MRZ-N/MRZN-RadioAmateur-Resources/hardware/placa_un_modulo/RF4463PRO.kicad_pcb

## KiCad design hardware/placa_un_modulo/RF4463PRO.kicad_pcb (2026-10-23)

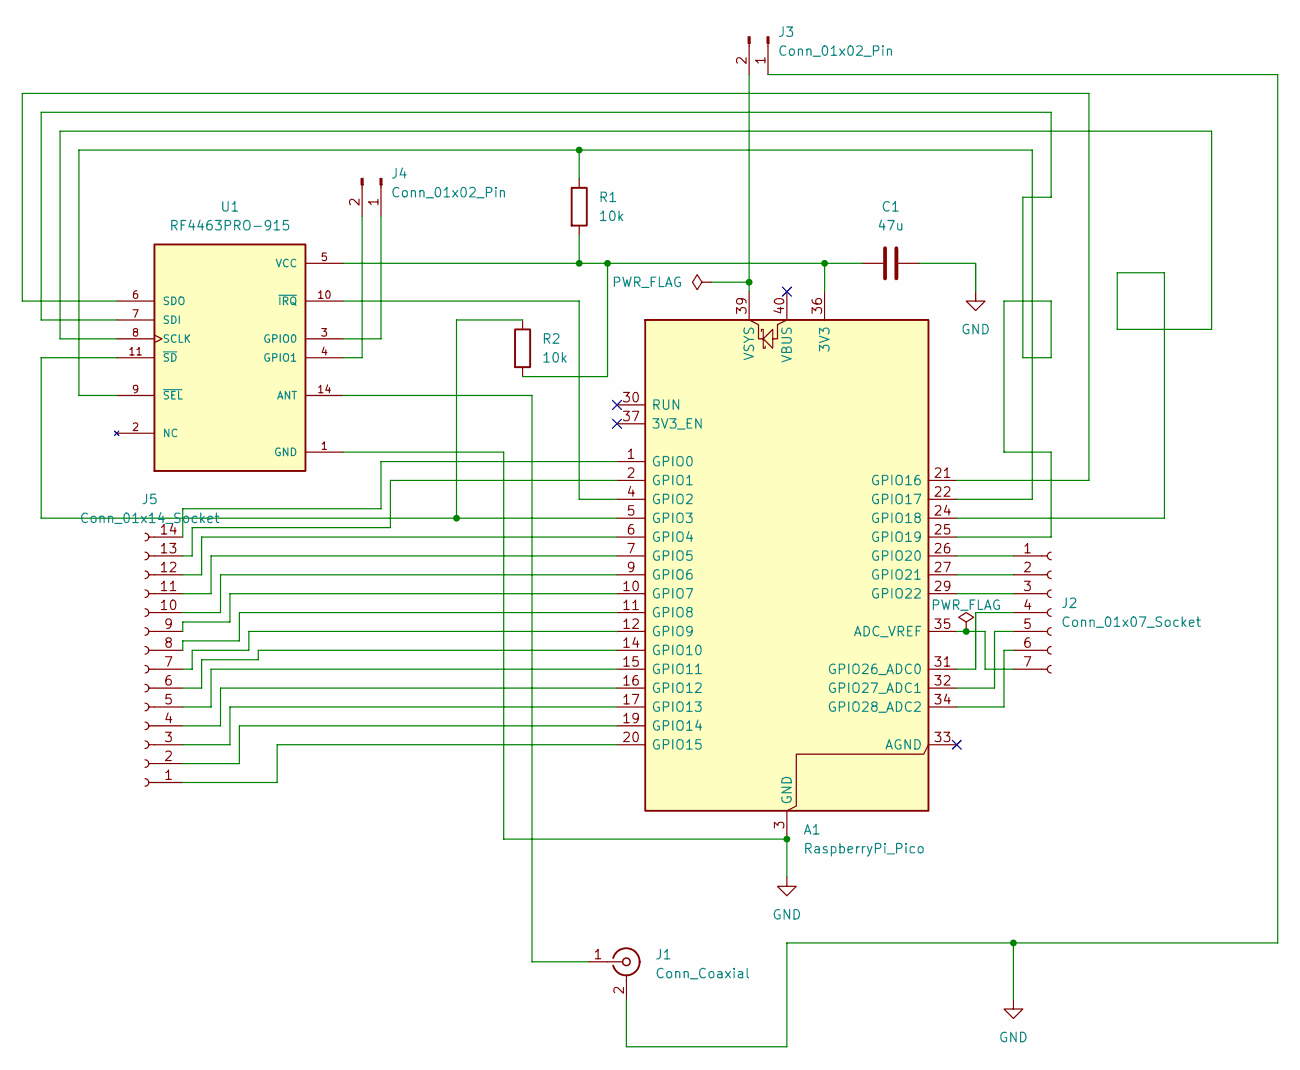
[picture p3: schematic RF4463PRO.kicad_sch]

Parts:
A1: RaspberryPi_Pico; RaspberryPi_Pico_SMD
C1: 47u; CP_Radial_D4.0mm_P2.00mm
J1: Conn_Coaxial; SMA_Amphenol_132289_EdgeMount
J2: Conn_01x07_Socket; PinSocket_1x07_P2.54mm_Vertical
J3: Conn_01x02_Pin; PinHeader_1x02_P2.54mm_Vertical
J4: Conn_01x02_Pin; PinSocket_1x02_P2.54mm_Vertical
J5: Conn_01x14_Socket; PinSocket_1x14_P2.54mm_Vertical
R1, R2: 10k; R_0805_2012Metric_Pad1.20x1.40mm_HandSolder
U1: RF4463PRO-915; XCVR_RF4463PRO-915; PARTREV V3.3

Connections:
GND: A1.3 (GND), A1.8 (GND), A1.13 (GND), A1.18 (GND), A1.23 (GND), A1.28 (GND), A1.38 (GND), C1.2, J1.2 (Ext), J3.1, U1.1 (GND), U1.12 (GND), U1.13 (GND)
unnamed: A1.36 (3V3), C1.1, R1.2, R2.2, U1.5 (VCC)
unnamed: A1.35 (ADC_VREF), J2.7
unnamed: A1.1 (GPIO0), J5.14
unnamed: A1.2 (GPIO1), J5.13
unnamed: A1.4 (GPIO2), U1.10 (~IRQ)
unnamed: A1.5 (GPIO3), R2.1, U1.11 (~SD)
unnamed: A1.6 (GPIO4), J5.12
unnamed: A1.7 (GPIO5), J5.11
unnamed: A1.9 (GPIO6), J5.10
unnamed: A1.10 (GPIO7), J5.9
unnamed: A1.11 (GPIO8), J5.8
unnamed: A1.12 (GPIO9), J5.7
unnamed: A1.14 (GPIO10), J5.6
unnamed: A1.15 (GPIO11), J5.5
unnamed: A1.16 (GPIO12), J5.4
unnamed: A1.17 (GPIO13), J5.3
unnamed: A1.19 (GPIO14), J5.2
unnamed: A1.20 (GPIO15), J5.1
unnamed: A1.21 (GPIO16), U1.6 (SDO)
unnamed: A1.22 (GPIO17), R1.1, U1.9 (~SEL)
unnamed: A1.24 (GPIO18), U1.8 (SCLK)
unnamed: A1.25 (GPIO19), U1.7 (SDI)
unnamed: A1.26 (GPIO20), J2.1
unnamed: A1.27 (GPIO21), J2.2
unnamed: A1.29 (GPIO22), J2.3
unnamed: A1.31 (GPIO26_ADC0), J2.4
unnamed: A1.32 (GPIO27_ADC1), J2.5
unnamed: A1.34 (GPIO28_ADC2), J2.6
unnamed: A1.39 (VSYS), J3.2
unnamed: J1.1 (In), U1.14 (ANT)
unnamed: J4.1, U1.3 (GPIO0)
unnamed: J4.2, U1.4 (GPIO1)

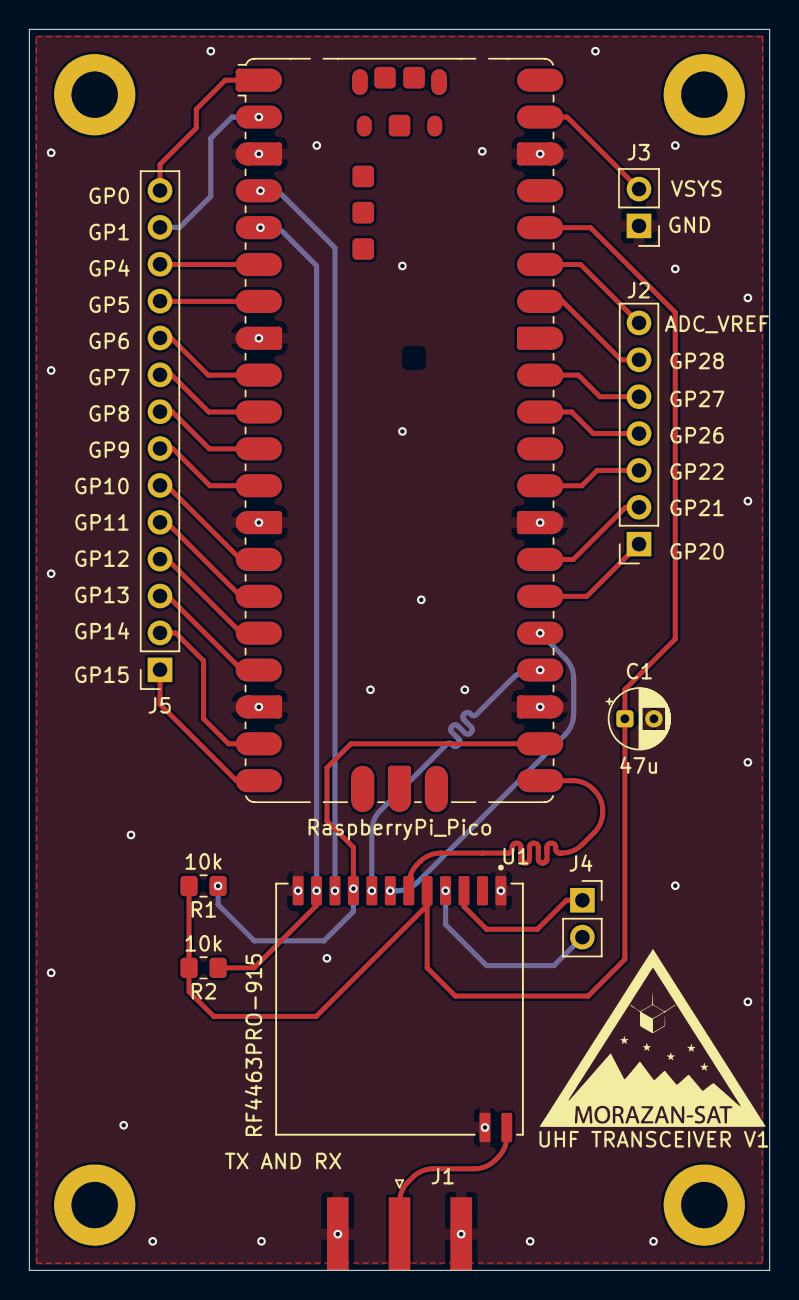
[picture p4: board hardware/placa_un_modulo/RF4463PRO.kicad_pcb from above]

Board: 4 copper layers, 51.0 x 85.5 mm, 10 parts (0 on the bottom side), 33 nets.
