MRZ-N/MRZN-RadioAmateur-Resources/firmware/rx_qsl/include/radio_config.h

/* ====================================================================
 * radio_config.h -- configuracion completa del Si4463 para el enlace
 * descendente del MRZN:
 *
 *   2GFSK, 9600 baudios, +/-2400 Hz, 435.500 MHz (frecuencia fija),
 *   cristal de 30 MHz
 *
 * Calculada con el calculador de modem de WDS (Wireless Development Suite,
 * Silicon Labs).  Para otra frecuencia hay que recalcularla con WDS.  Aqui
 * solo estan los valores resultantes: no hay ningun archivo de WDS.
 *
 * SPDX-License-Identifier: GPL-3.0-only
 *
 * Formato: <n> <orden> <n-1 bytes> ... terminado en 0x00.  rf4463_rx.h lo
 * recorre y despues reescribe y relee los parametros del paquete.
 * ==================================================================== */

#ifndef RADIO_CONFIG_H_
#define RADIO_CONFIG_H_

#define RADIO_CONFIGURATION_DATA_ARRAY { \
    8, 0x11, 0x01, 0x04, 0x00, 0x03, 0xFF, 0xFF, 0x00,                              /* INT_CTL 0x00..0x03 */ \
    6, 0x11, 0x10, 0x02, 0x00, 0x05, 0x0C,                                          /* PREAMBLE 0x00..0x01 */ \
    5, 0x11, 0x10, 0x01, 0x04, 0x32,                                                /* PREAMBLE 0x04 */ \
    6, 0x11, 0x11, 0x02, 0x00, 0x00, 0x7E,                                          /* SYNC 0x00..0x01 */ \
    5, 0x11, 0x12, 0x01, 0x00, 0x00,                                                /* PKT 0x00 */ \
    5, 0x11, 0x12, 0x01, 0x06, 0x00,                                                /* PKT 0x06 */ \
    16, 0x11, 0x12, 0x0C, 0x08, 0x00, 0x00, 0x00, 0x10, 0x10, 0x00, 0x83, 0x00, 0x00, 0x00, 0x00, 0x00,/* PKT 0x08..0x13 */ \
    16, 0x11, 0x12, 0x0C, 0x14, 0x00, 0x00, 0x00, 0x00, 0x00, 0x00, 0x00, 0x00, 0x00, 0x00, 0x00, 0x00,/* PKT 0x14..0x1F */ \
    5, 0x11, 0x12, 0x01, 0x20, 0x00,                                                /* PKT 0x20 */ \
    16, 0x11, 0x20, 0x0C, 0x00, 0x03, 0x00, 0x07, 0x05, 0xDC, 0x00, 0x05, 0xC9, 0xC3, 0x80, 0x00, 0x00,/* MODEM 0x00..0x0B */ \
    5, 0x11, 0x20, 0x01, 0x0C, 0xA8,                                                /* MODEM 0x0C */ \
    16, 0x11, 0x20, 0x0C, 0x18, 0x01, 0x00, 0x08, 0x03, 0x80, 0x00, 0x30, 0x20, 0x00, 0xE8, 0x00, 0xC3,/* MODEM 0x18..0x23 */ \
    16, 0x11, 0x20, 0x0C, 0x24, 0x02, 0x9F, 0x17, 0x05, 0x40, 0x02, 0x00, 0x00, 0x00, 0x12, 0xC0, 0x54,/* MODEM 0x24..0x2F */ \
    7, 0x11, 0x20, 0x03, 0x30, 0x03, 0xC4, 0xE0,                                    /* MODEM 0x30..0x32 */ \
    5, 0x11, 0x20, 0x01, 0x35, 0xE0,                                                /* MODEM 0x35 */ \
    9, 0x11, 0x20, 0x05, 0x38, 0x11, 0x2B, 0x2B, 0x80, 0x1A,                        /* MODEM 0x38..0x3C */ \
    9, 0x11, 0x20, 0x05, 0x3F, 0x00, 0x29, 0x0C, 0xA4, 0x23,                        /* MODEM 0x3F..0x43 */ \
    9, 0x11, 0x20, 0x05, 0x45, 0x03, 0x00, 0x35, 0x02, 0x00,                        /* MODEM 0x45..0x49 */ \
    8, 0x11, 0x20, 0x04, 0x4B, 0x0F, 0x02, 0x18, 0x40,                              /* MODEM 0x4B..0x4E */ \
    6, 0x11, 0x20, 0x02, 0x50, 0x84, 0x0A,                                          /* MODEM 0x50..0x51 */ \
    6, 0x11, 0x20, 0x02, 0x54, 0x03, 0x07,                                          /* MODEM 0x54..0x55 */ \
    5, 0x11, 0x20, 0x01, 0x57, 0x00,                                                /* MODEM 0x57 */ \
    9, 0x11, 0x20, 0x05, 0x5B, 0x40, 0x04, 0x04, 0x78, 0x20,                        /* MODEM 0x5B..0x5F */ \
    8, 0x11, 0x22, 0x04, 0x00, 0x08, 0x7F, 0x00, 0x1D,                              /* PA 0x00..0x03 */ \
    11, 0x11, 0x23, 0x07, 0x00, 0x2C, 0x0E, 0x0B, 0x04, 0x0C, 0x73, 0x03,           /* SYNTH 0x00..0x06 */ \
    12, 0x11, 0x40, 0x08, 0x00, 0x39, 0x08, 0x88, 0x88, 0x44, 0x44, 0x20, 0xFE,     /* FREQ_CONTROL 0x00..0x07 */ \
    0x00 \
}

#define RADIO_CONFIGURATION_DATA_RADIO_XO_FREQ  30000000L

#endif /* RADIO_CONFIG_H_ */
